NottingHack/nh-tool-wifi/uvdtf-decal.png

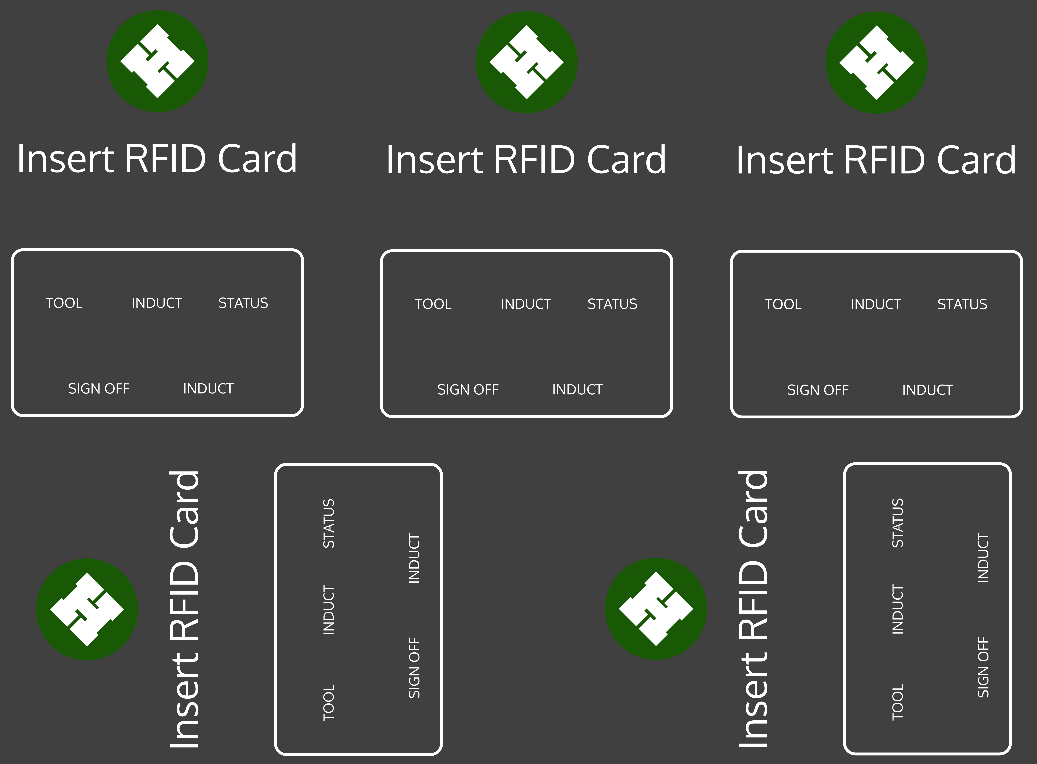
uvdtf-decal.png
