NottingHack/nh-tool-wifi/Enclosure.FCStd

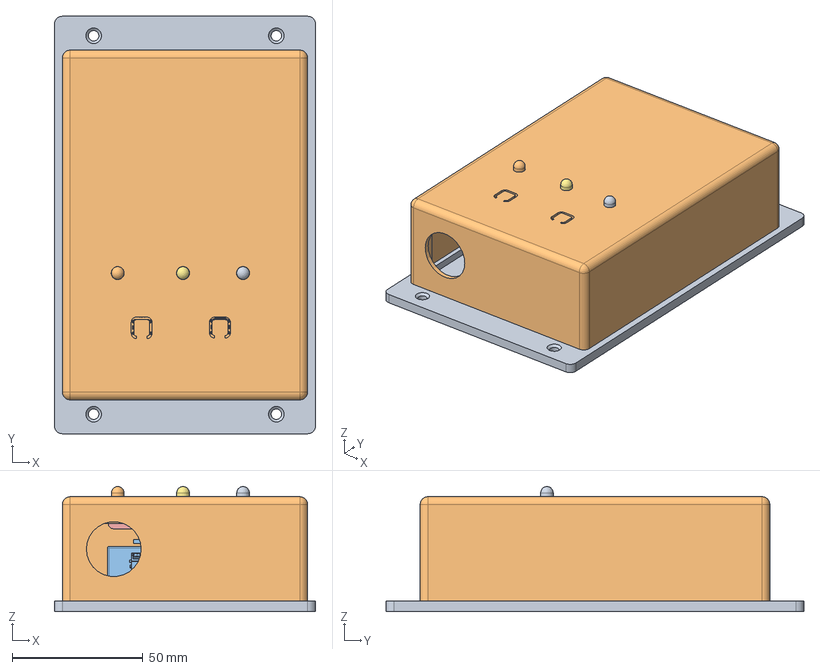
[picture p2: CAD file, 2026-03-28]
Enclosure.FCStd
100.0 x 160.0 x 47.9 mm
Base
Lid
Komponente1
Komponente2
Pin Header 2,54 mm v4 (7)
Pin Header 2,54 mm v4 (6)
Pin Header 2,54 mm v4 (5)
Pin Header 2,54 mm v4 (4)
Pin Header 2,54 mm v4 (3)
Pin Header 2,54 mm v4 (2)
Pin Header 2,54 mm v4 (1)
Pin Header 2,54 mm v4
R-0805 v4
Komponente003
R-0805 v005
R-0805 v006
R-0805 v007
R-0805 v008
R-0805 v009
R-0805 v010
R-0805 v011
R-0805 v012
R-0805 v013
R-0805 v014
R-0805 v015
R-0805 v016
R-0805 v017
R-0805 v018
R-0805 v019
R-0805 v020
R-0805 v021
R-0805 v022
R-0805 v023
R-0805 v024
RC522
NFC
Schrift
SW_PUSH_6mm
LED_D5.0mm
SW_PUSH_6mm001
LED_D5.0mm001
LED_D5.0mm002
front_copper
front_copper001
front_copper002
front_copper003
front_copper004
front_copper005
front_copper006
front_silkscreen
front_silkscreen001
front_silkscreen002
front_silkscreen003
front_silkscreen004
front_silkscreen005
front_silkscreen006
front_silkscreen007
front_silkscreen008
front_silkscreen009
front_silkscreen010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
