NottingHack/nh-tool-wifi/wifi-nh-tools/wifi-nh-tools.kicad_pcb

## KiCad design wifi-nh-tools/wifi-nh-tools.kicad_pcb (2026-03-21)

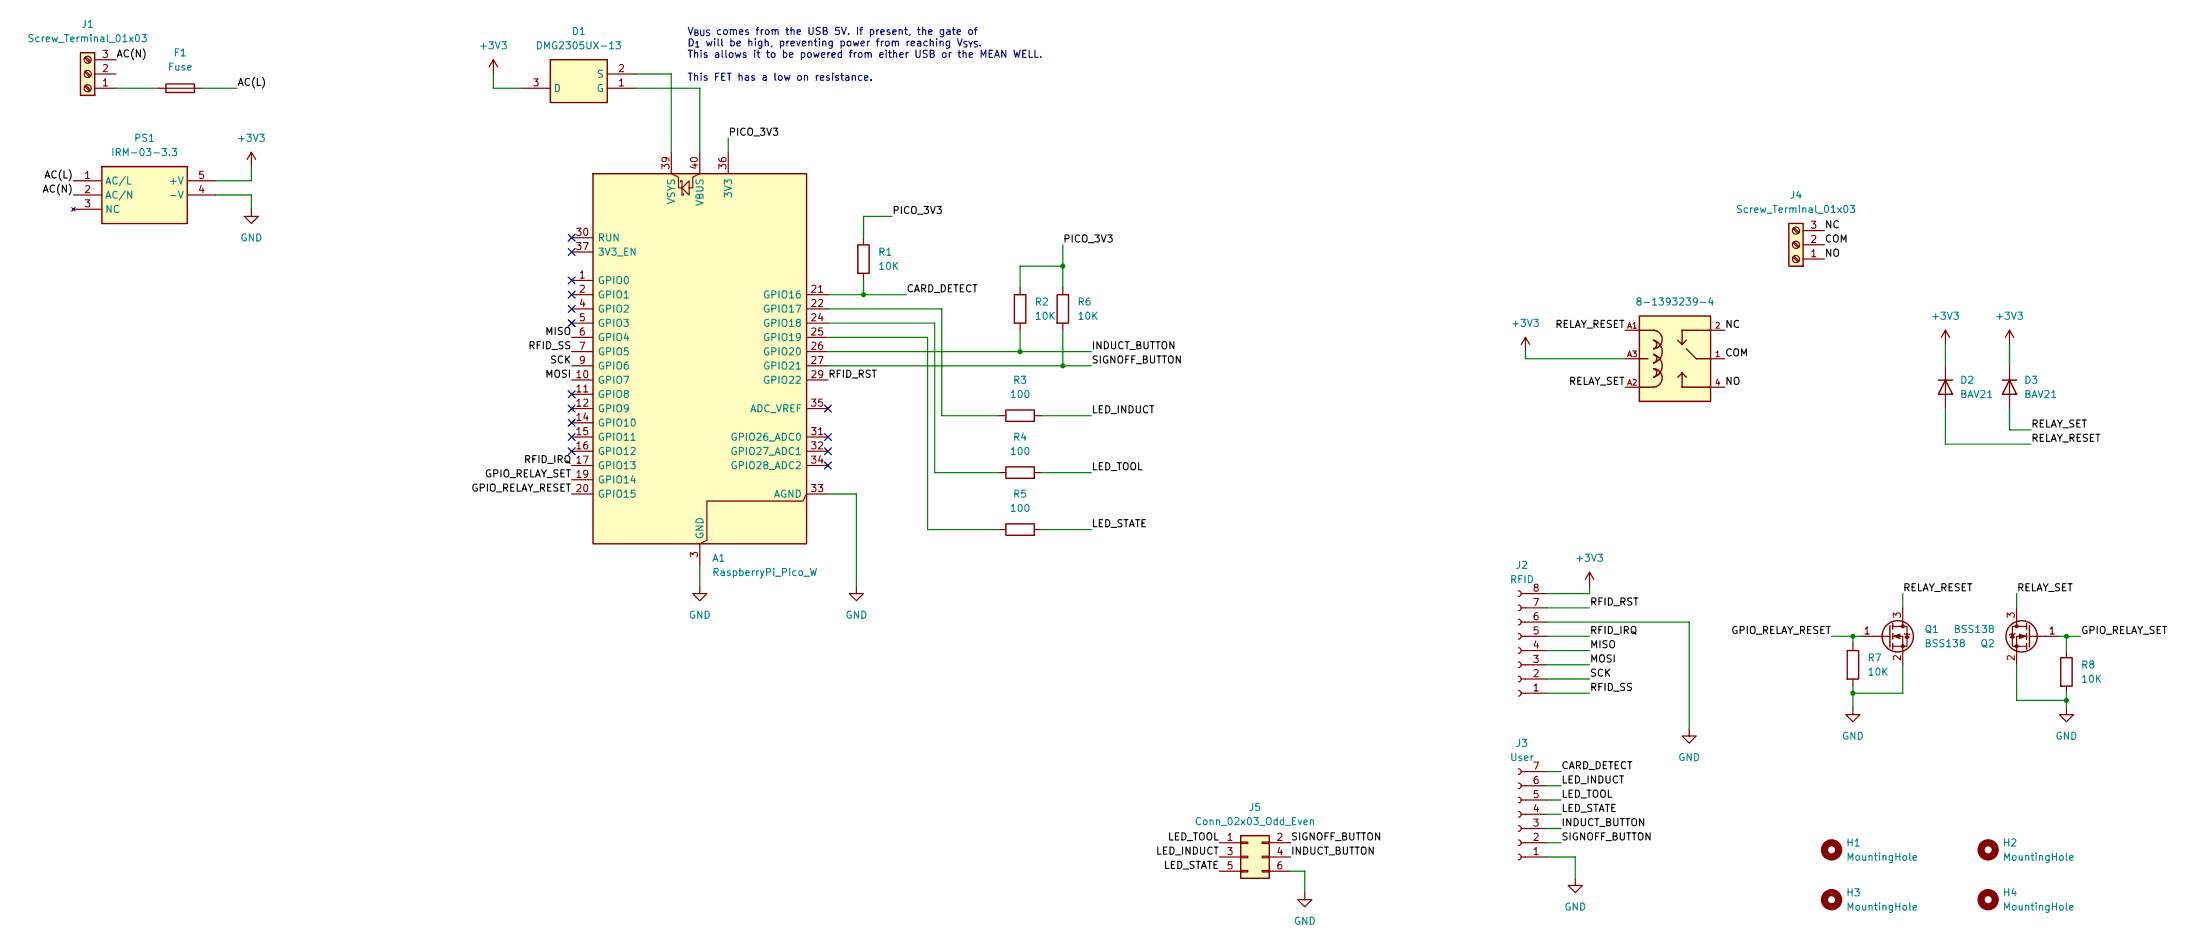
[picture p3: schematic wifi-nh-tools.kicad_sch]

Parts:
A1: RaspberryPi_Pico_W; RaspberryPi_Pico_W_SMD_HandSolder
D1: DMG2305UX-13; SOT96P240X120-3N; MPN DMG2305UX-13
D2, D3: BAV21; Nexperia_CFP3_SOD-123W; MPN BAV21WS-AQ
F1: Fuse; Fuse_Littelfuse-NANO2-462; MPN 0443002.DR
H1, H2, H3, H4: MountingHole; MountingHole_3.2mm_M3
J1, J4: Screw_Terminal_01x03; TerminalBlock_WAGO_2601-1103_1x03_P3.50mm_Horizontal; MPN 2601-1103
J2: RFID; PinSocket_1x08_P2.54mm_Vertical; MPN 61900811121
J3: User; PinSocket_1x07_P2.54mm_Vertical; MPN 61900811121
J5: Conn_02x03_Odd_Even; PinSocket_2x03_P2.54mm_Vertical; MPN 61303218421
K1: 8-1393239-4; TE_8-1393239-4; MPN 8-1393239-4
PS1: IRM-03-3.3; IRM035; MPN IRM-03-3.3
Q1, Q2: BSS138; SOT-23; MPN BSS138
R1, R2, R6: 10K; R_0603_1608Metric
R3, R4, R5: 100; R_0603_1608Metric
R7, R8: 10K; R_0603_1608Metric; MPN 560112116005

Connections:
+3V3: D1.3 (D), D2.1 (K), D3.1 (K), J2.8, K1.A3, PS1.5 (+V)
/AC(L): F1.2, PS1.1 (AC/L)
/AC(N): J1.3, PS1.2 (AC/N)
/CARD_DETECT: A1.21 (GPIO16), J3.7, R1.2
/COM: J4.2, K1.1, K1.11
/GPIO_RELAY_RESET: A1.20 (GPIO15), Q1.1 (G), R7.1
/GPIO_RELAY_SET: A1.19 (GPIO14), Q2.1 (G), R8.1
/INDUCT_BUTTON: A1.26 (GPIO20), J3.3, J5.4, R2.2
/LED_INDUCT: J3.6, J5.3, R3.2
/LED_STATE: J3.4, J5.5, R5.2
/LED_TOOL: J3.5, J5.1, R4.2
/MISO: A1.6 (GPIO4), J2.4
/MOSI: A1.10 (GPIO7), J2.3
/NC: J4.3, K1.2, K1.12
/NO: J4.1, K1.4, K1.14
/PICO_3V3: A1.36 (3V3), R1.1, R2.1, R6.1
/RELAY_RESET: D2.2 (A), K1.A1, Q1.3 (D)
/RELAY_SET: D3.2 (A), K1.A2, Q2.3 (D)
/RFID_IRQ: A1.17 (GPIO13), J2.5
/RFID_RST: A1.29 (GPIO22), J2.7
/RFID_SS: A1.7 (GPIO5), J2.1
/SCK: A1.9 (GPIO6), J2.2
/SIGNOFF_BUTTON: A1.27 (GPIO21), J3.2, J5.2, R6.2
GND: A1.3 (GND), A1.8 (GND), A1.13 (GND), A1.18 (GND), A1.23 (GND), A1.28 (GND), A1.33 (AGND), A1.38 (GND), J2.6, J3.1, J5.6, PS1.4 (-V), Q1.2 (S), Q2.2 (S), R7.2, R8.2
unnamed: A1.22 (GPIO17), R3.1
unnamed: A1.24 (GPIO18), R4.1
unnamed: A1.25 (GPIO19), R5.1
unnamed: A1.40 (VBUS), D1.1 (G)
unnamed: A1.39 (VSYS), D1.2 (S)
unnamed: F1.1, J1.1

Notes on the sheet:
V_{BUS} comes from the USB 5V. If present, the gate of D_{1} will be high, preventing power from reaching V_{SYS}. This allows it to be powered from either USB or the MEAN WELL. This FET has a low on resistance.

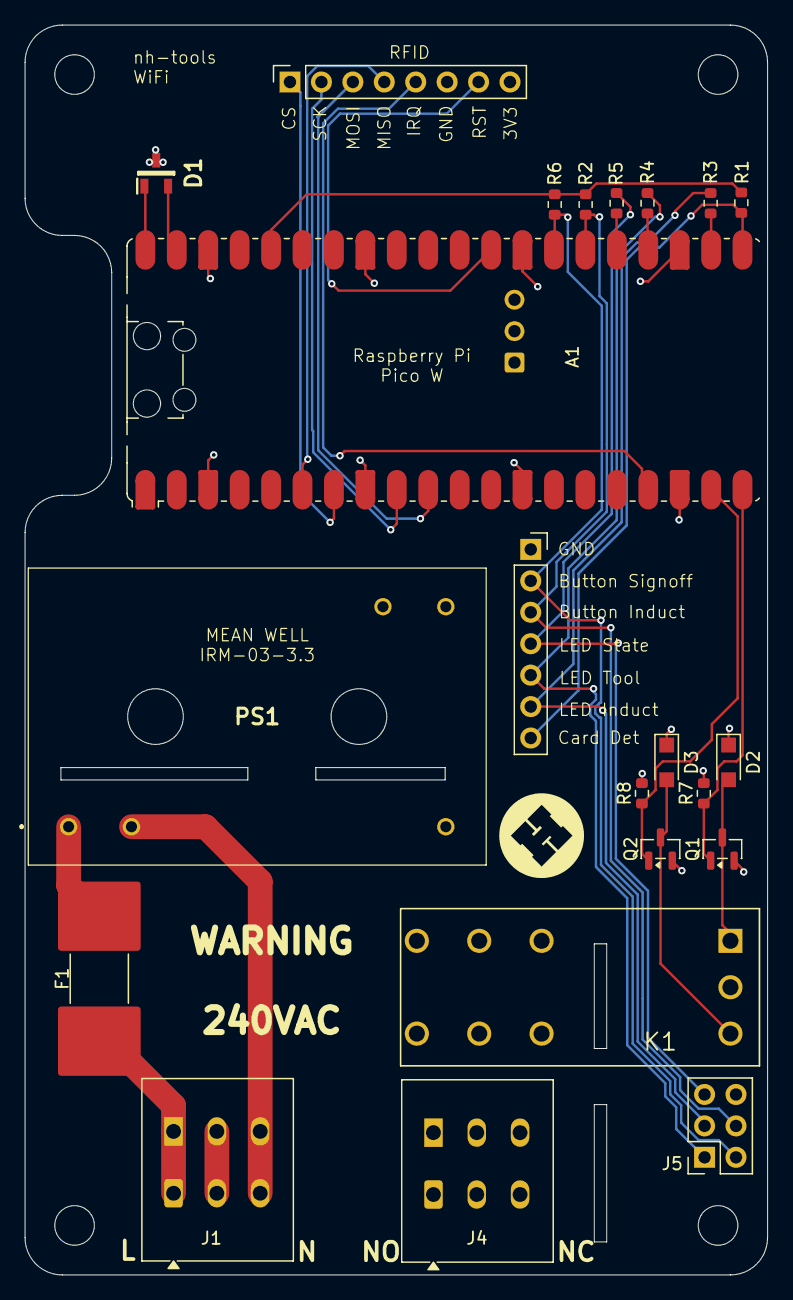
[picture p4: board wifi-nh-tools.kicad_pcb from above]

Board: 4 copper layers, 60.0 x 101.0 mm, 26 parts (0 on the bottom side), 30 nets.
