NottingHack/nh-tool-wifi/front/front.kicad_pcb

## KiCad design front/front.kicad_pcb (2026-03-17)

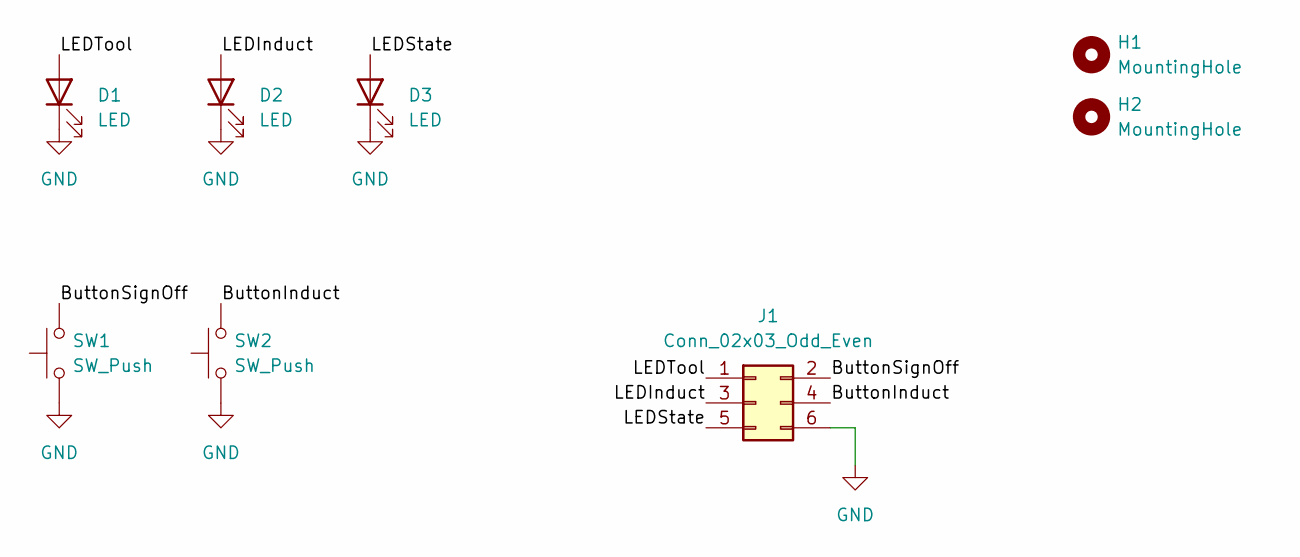
[picture p5: schematic front.kicad_sch]

Parts:
D1, D2, D3: LED; LED_D5.0mm
H1, H2: MountingHole; MountingHole_3.2mm_M3
J1: Conn_02x03_Odd_Even; PinHeader_2x03_P2.54mm_Vertical; MPN 61303218421
SW1, SW2: SW_Push; SW_PUSH_6mm

Connections:
/ButtonInduct: J1.4, SW2.2
/ButtonSignOff: J1.2, SW1.2
/LEDInduct: D2.2 (A), J1.3
/LEDState: D3.2 (A), J1.5
/LEDTool: D1.2 (A), J1.1
GND: D1.1 (K), D2.1 (K), D3.1 (K), J1.6, SW1.1, SW2.1

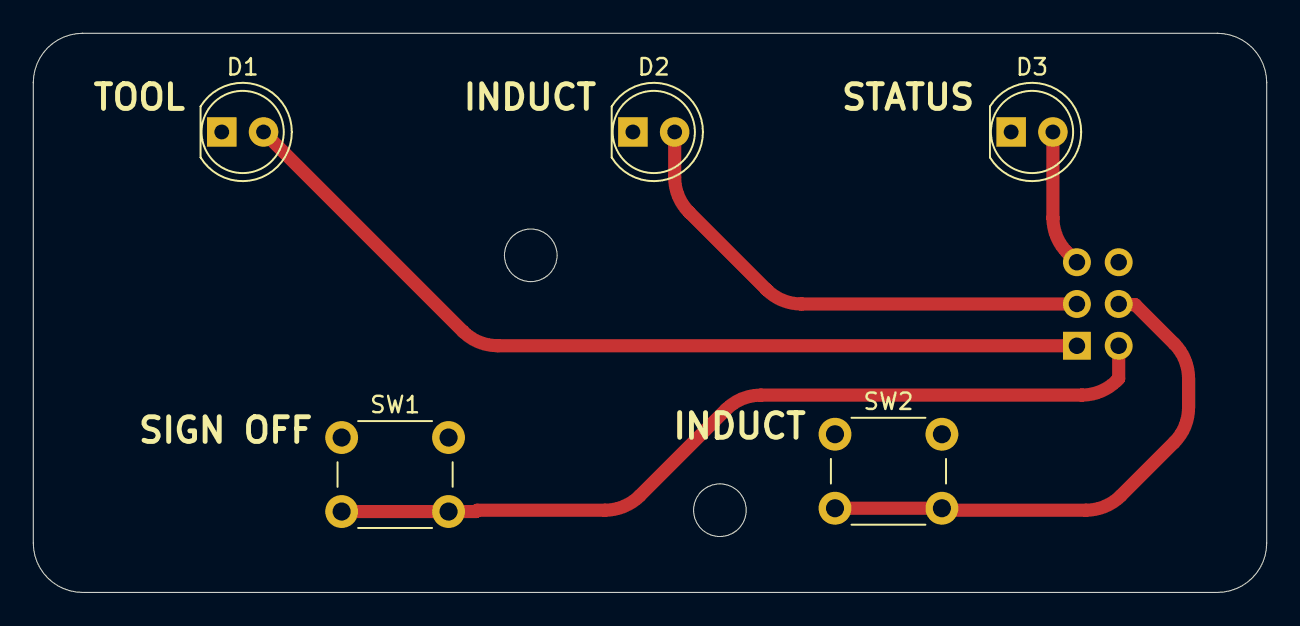
[picture p6: board front.kicad_pcb from above]

Board: 2 copper layers, 75.0 x 34.0 mm, 8 parts (1 on the bottom side), 6 nets.
