NottingHack/nh-tool-wifi/(commit log)

2026-03-20 Hopefully the working enclosure...
    [Enclosure.FCStd]
2026-03-21 Fix solder mask on high current traces
    [wifi-nh-tools.kicad_pcb]
2026-03-25 Add card holder
    [Enclosure.FCStd]
2026-03-28 Move gland opening away from edge
    [Enclosure.FCStd]
2026-03-28 add pico-mqtt lib
2026-04-01 Create a task to read the buttons, a task to drive the leds, and a test task to plumb their queues together.
2026-04-06 Remove extra debug and excessive delays. Disable SPI debug.
2026-11-10 Implement state machine except for: - Connect/disconnect handling - Timeouts - Active time tracking - LED output Fix typo in the test script's ISUC topic
2026-11-11 Implement timeouts, LEDs, and relays.
2026-11-14 Only update LEDs if the state changed Run the relay task instead of a second LED task
2026-11-14 Only try to set / reset the relay if the state has changed.
